JochiSt/OpenHVNanoAmpMeter/README.md

# OpenHVNanoAmpMeter
 Measure Nano Ampere at a high voltage supply
