JochiSt/OpenHVNanoAmpMeter/software/calculations_DDC112/IFS_vs_Tint_vs_CF.png

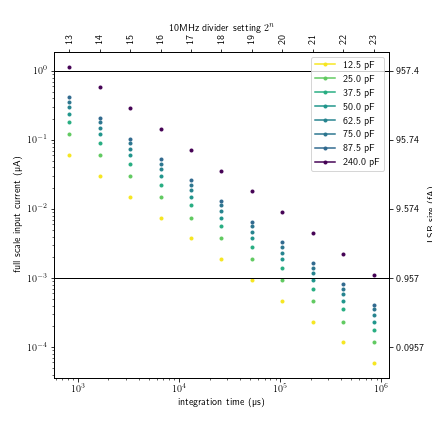
software/calculations_DDC112/IFS_vs_Tint_vs_CF.png
