JochiSt/OpenHVNanoAmpMeter/simulations/CurrentSensor.asc

C1: cap; 10p
C2: cap; 100n
C3: cap; 100n
C4: cap; 10n
C5: cap; 100n
C6: cap; 100n
C7: cap; 100n
C8: cap; 100n
C9: cap; 10n
C10: cap; 100n
C11: cap; 100n
C12: cap; 100n
C13: cap; 10n
C14: cap; 100n
C15: cap; 100n
C16: cap; 100n
I1: current; PWL(0 0 10 1n 20 10n 30 100n)
R1: res; 47Meg
R2: res; 10k
R3: res; 330k
R4: res; 4k7
R5: res; 10k
R6: res; 8k2
R7: res; 82k
R8: res; 47k
R9: res; 100k
R10: res; 10
R11: res; 180k
R12: res; 10k
R13: res; 82k
R14: res; 47k
R15: res; 100k
R16: res; 36k
R17: res; 10k
R18: res; 82k
R19: res; 47k
R20: res; 100k
U1: opamp2; TLC272
U2: LT1493
U3: LT1493
U4: LT1493
V1: voltage; 5; Rser=10
V2: voltage; 5; Rser=10
V3: voltage; 1k
Named nets: V+, V-, Vo, V0, 0, Vi, Vo2_1, Vo2_2, Vo2_3
.lib TLC272.5_1
;tran 100m
Guard Ring
external bias
supply voltage generation
TIA
inv. amplifier
;noise V(Vo2) I1 dec 1000 0.1 1G
low pass filter
low pass filter
.tran 40
low pass filter
use R4 + R5 + R6 + R2 and R3 to 
calculate the amplification
input protection resistor
inv. amplifier
low pass filter
low pass filter
inv. amplifier
low pass filter
low pass filter
