JochiSt/OpenHVNanoAmpMeter/simulations/DDC112/ManchesterCoding/ManchesterCoding.asc

A1: dflop
A2: xor
V1: voltage; PWL file=uart_tx.txt
V2: voltage; PULSE(0 3.3 0 1n 1n 5u 10u)
Named nets: 0, UART_TX, 1b2b
.tran 2m
