JochiSt/OpenHVNanoAmpMeter/OpenHVNanoAmpMeter.kicad_pcb

## KiCad design OpenHVNanoAmpMeter.kicad_pcb (2022-11-25)

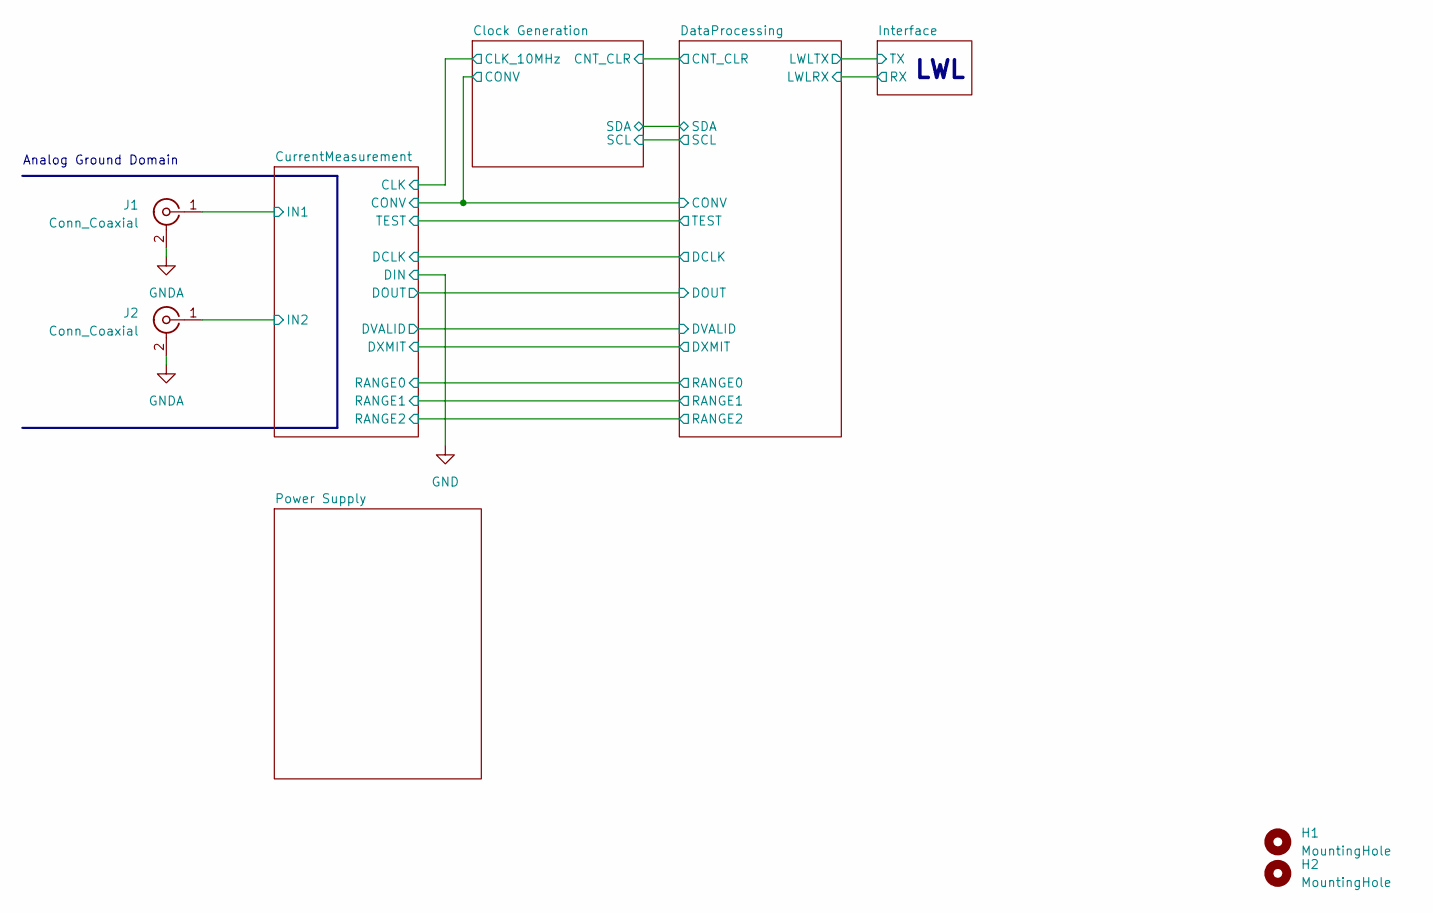
[picture p2: schematic OpenHVNanoAmpMeter.kicad_sch, Open Nano Amp Meter]

Parts:
H1, H2: MountingHole; MountingHole_3.2mm_M3_DIN965
J1, J2: Conn_Coaxial; SMA_Amphenol_132289_EdgeMount

Connections:
/CurrentMeasurement/IN1: J1.1 (In); also elsewhere on the board
/CurrentMeasurement/IN2: J2.1 (In); also elsewhere on the board
GNDA: J1.2 (Ext), J2.2 (Ext); also elsewhere on the board

Notes on the sheet:
LWL
Analog Ground Domain

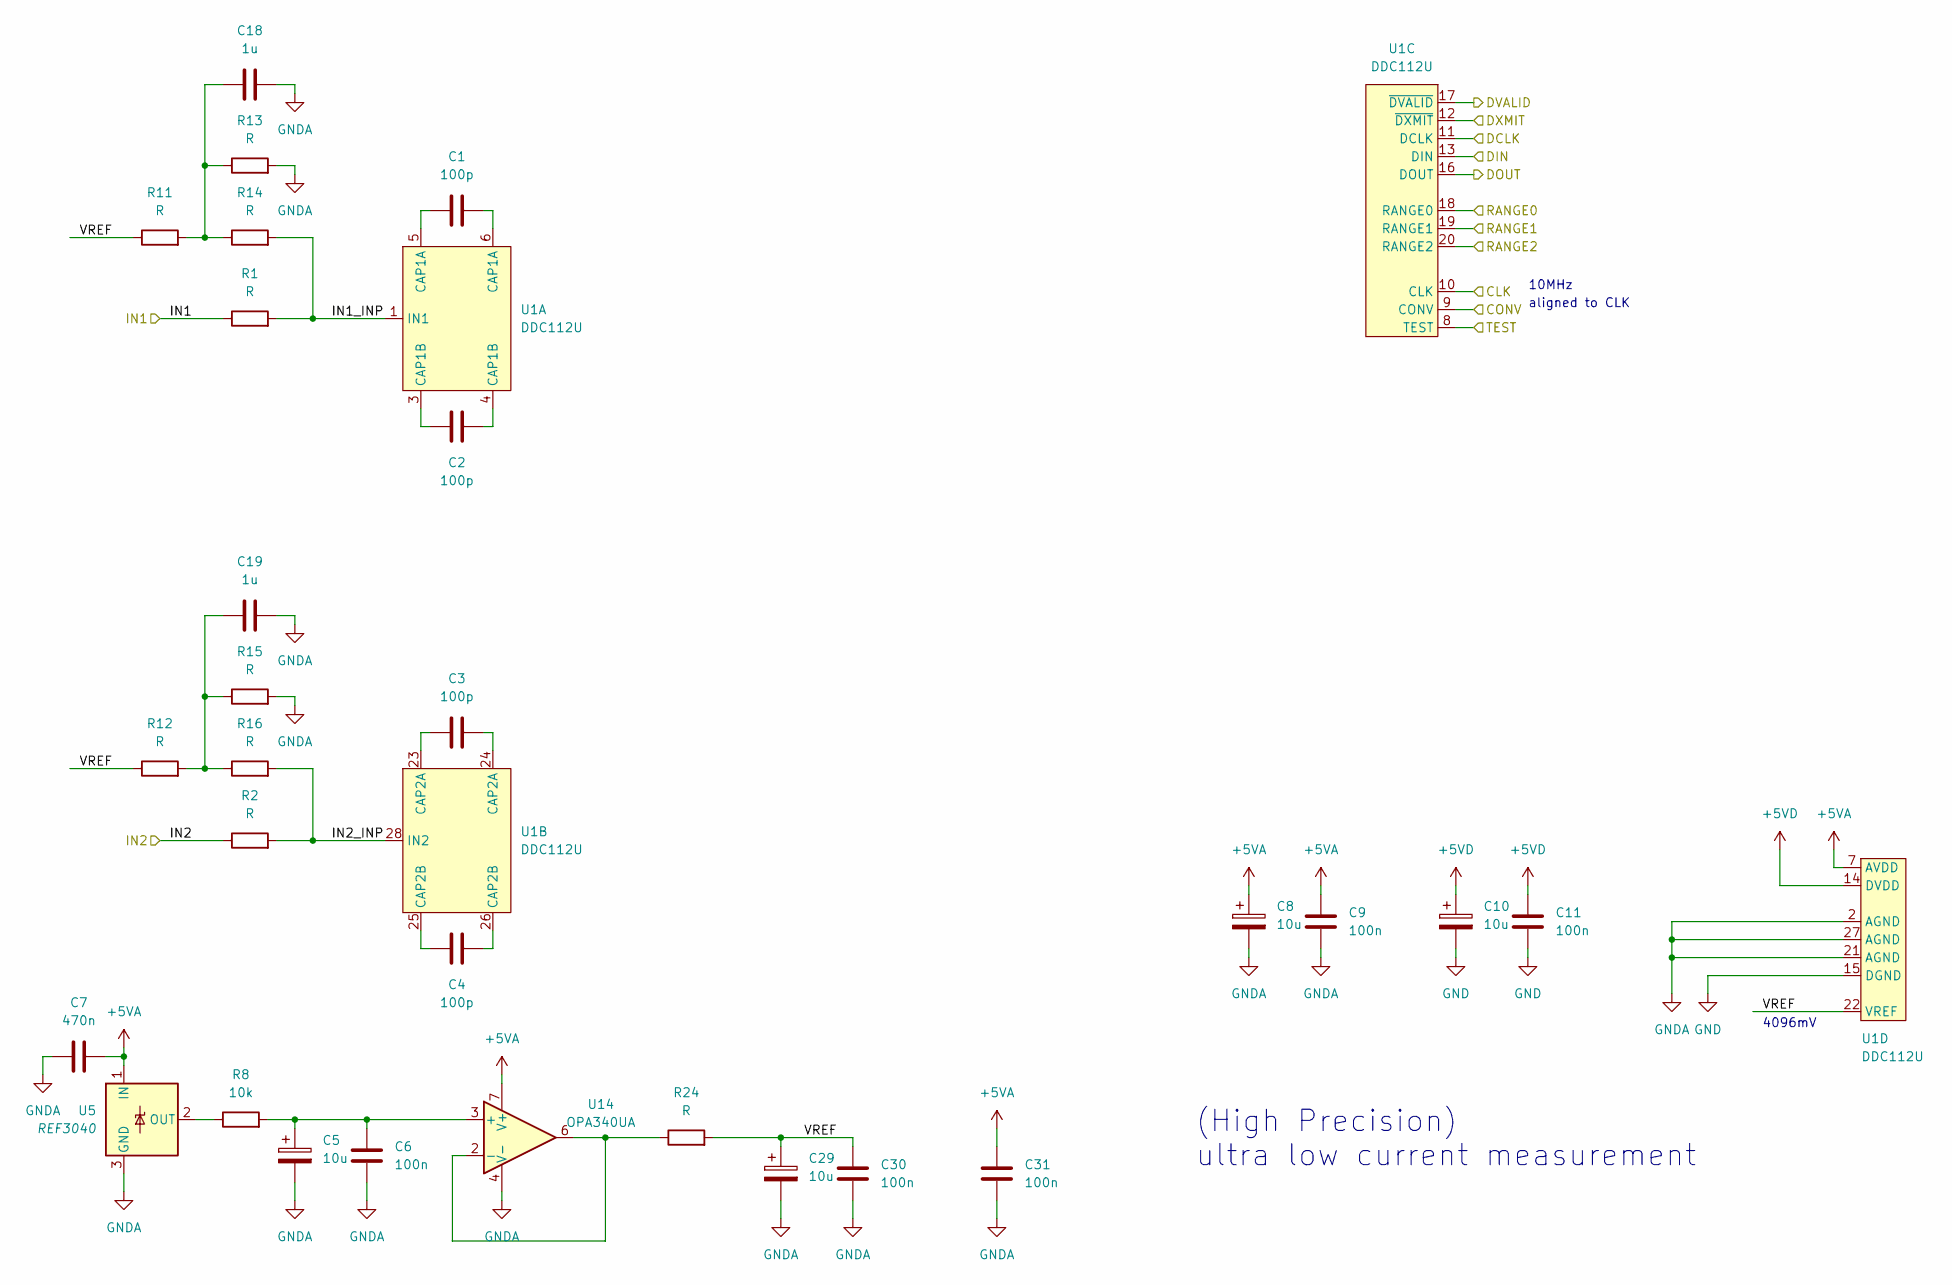
[picture p3: schematic CurrentMeasurement.kicad_sch, Open Nano Amp Meter]

Parts:
C1, C2, C3, C4: 100p; C_0402_1005Metric_Pad0.74x0.62mm_HandSolder
C5, C8, C10, C29: 10u; CP_Elec_4x3.9
C6, C9, C11, C30, C31: 100n; C_0603_1608Metric
C7: 470n; C_0603_1608Metric
C18, C19: 1u; C_0603_1608Metric
R1, R2, R11, R12, R13, R14, R15, R16, R24: R; R_0603_1608Metric
R8: 10k; R_0603_1608Metric
U1: DDC112U; SOIC-28W_7.5x17.9mm_P1.27mm
U5: REF3040; SOT-23
U14: OPA340UA; SOIC-8_3.9x4.9mm_P1.27mm

Connections:
+5VA: C7.2, C8.1, C9.1, C31.1, U1.7 (AVDD), U5.1 (IN), U14.7 (V+); also elsewhere on the board
+5VD: C10.1, C11.1, U1.14 (DVDD); also elsewhere on the board
/Clock Generation/CLK_10MHz: U1.10 (CLK); also elsewhere on the board
/Clock Generation/CONV: U1.9 (CONV); also elsewhere on the board
/CurrentMeasurement/DCLK: U1.11 (DCLK); also elsewhere on the board
/CurrentMeasurement/DOUT: U1.16 (DOUT); also elsewhere on the board
/CurrentMeasurement/DVALID: U1.17 (~DVALID); also elsewhere on the board
/CurrentMeasurement/DXMIT: U1.12 (~DXMIT); also elsewhere on the board
/CurrentMeasurement/IN1: R1.1; also elsewhere on the board
/CurrentMeasurement/IN1_INP: R1.2, R14.2, U1.1 (IN1)
/CurrentMeasurement/IN2: R2.1; also elsewhere on the board
/CurrentMeasurement/IN2_INP: R2.2, R16.2, U1.28 (IN2)
/CurrentMeasurement/RANGE0: U1.18 (RANGE0); also elsewhere on the board
/CurrentMeasurement/RANGE1: U1.19 (RANGE1); also elsewhere on the board
/CurrentMeasurement/RANGE2: U1.20 (RANGE2); also elsewhere on the board
/CurrentMeasurement/TEST: U1.8 (TEST); also elsewhere on the board
/CurrentMeasurement/VREF: C29.1, C30.1, R11.1, R12.1, R24.2, U1.22 (VREF)
GND: C10.2, C11.2, U1.13 (DIN), U1.15 (DGND); also elsewhere on the board
GNDA: C5.2, C6.2, C7.1, C8.2, C9.2, C18.2, C19.2, C29.2, C30.2, C31.2, R13.2, R15.2, U1.2 (AGND), U1.21 (AGND), U1.27 (AGND), U5.3 (GND), U14.4 (V-); also elsewhere on the board
unnamed: C1.1, U1.5 (CAP1A)
unnamed: C1.2, U1.6 (CAP1A)
unnamed: C2.1, U1.3 (CAP1B)
unnamed: C2.2, U1.4 (CAP1B)
unnamed: C3.1, U1.23 (CAP2A)
unnamed: C3.2, U1.24 (CAP2A)
unnamed: C4.1, U1.25 (CAP2B)
unnamed: C4.2, U1.26 (CAP2B)
unnamed: C5.1, C6.1, R8.2, U14.3 (+)
unnamed: C18.1, R11.2, R13.1, R14.1
unnamed: C19.1, R12.2, R15.1, R16.1
unnamed: R8.1, U5.2 (OUT)
unnamed: R24.1, U14.2 (-), U14.6

Notes on the sheet:
4096mV
aligned to CLK
(High Precision) ultra low current measurement
10MHz

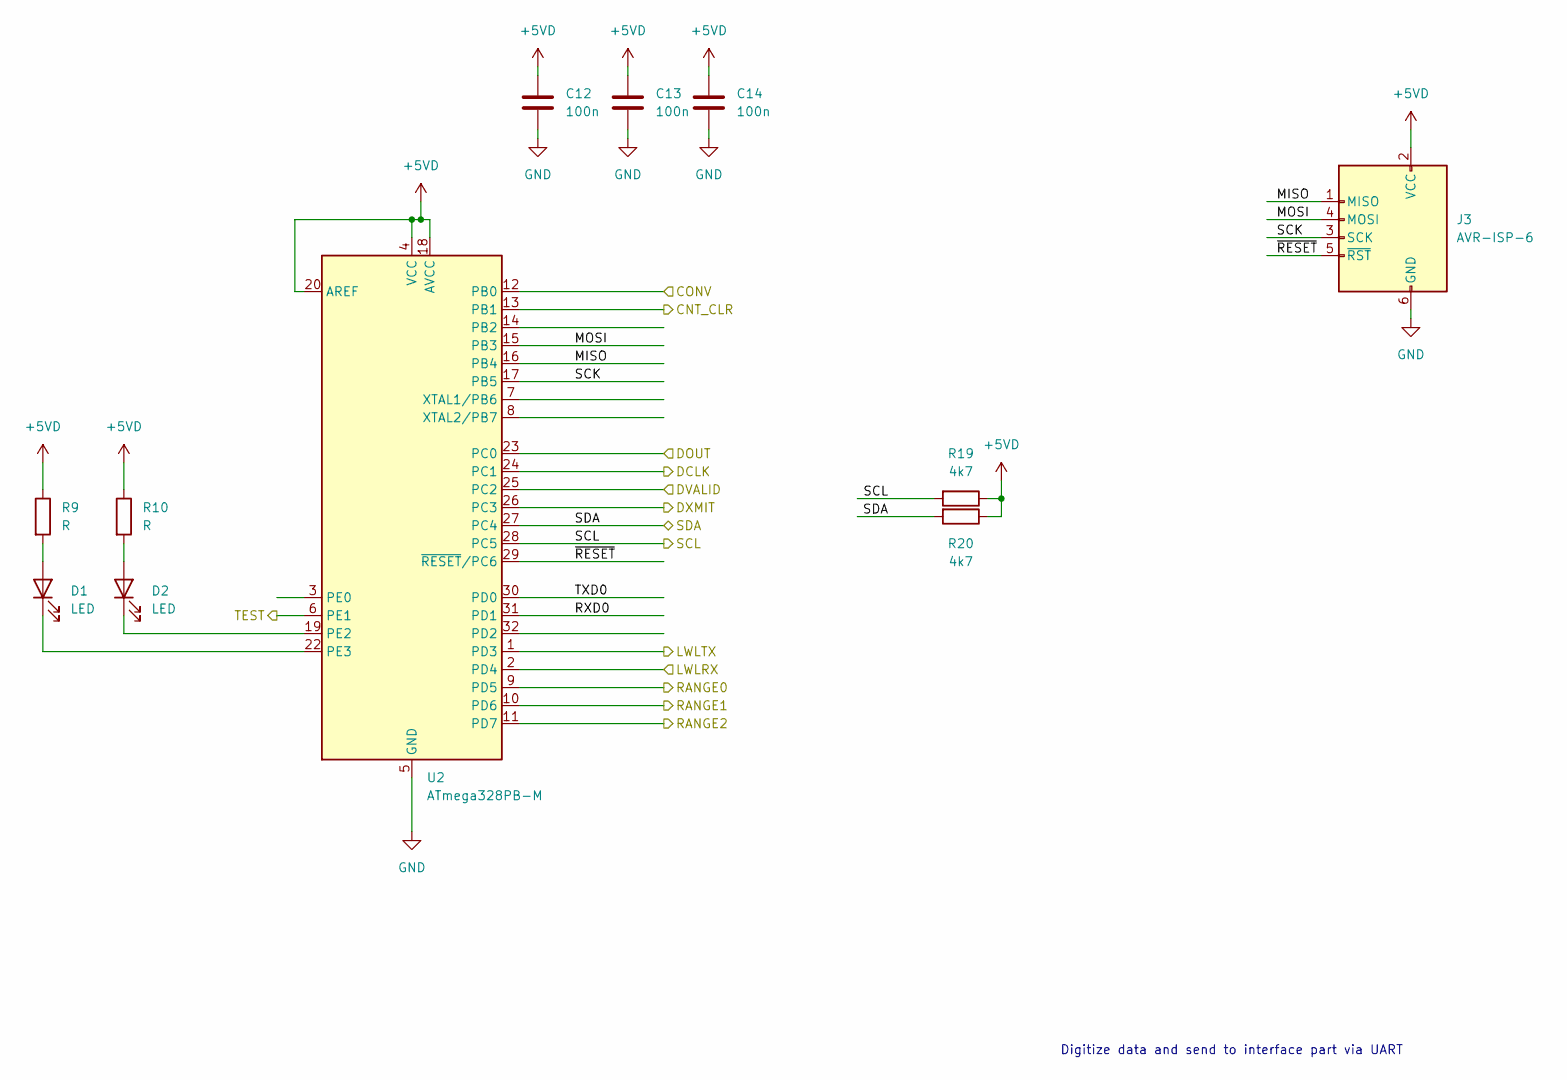
[picture p4: schematic DataProcessing.kicad_sch, Open Nano Amp Meter]

Parts:
C12, C13, C14: 100n; C_0603_1608Metric
D1, D2: LED; LED_0603_1608Metric
J3: AVR-ISP-6; PinHeader_2x03_P2.54mm_Vertical_SMD
R9, R10: R; R_0603_1608Metric
R19, R20: 4k7; R_0603_1608Metric
U2: ATmega328PB-M; QFN-32-1EP_5x5mm_P0.5mm_EP3.1x3.1mm

Connections:
+5VD: C12.1, C13.1, C14.1, J3.2 (VCC), R9.1, R10.1, R19.1, R20.1, U2.4 (VCC), U2.18 (AVCC), U2.20 (AREF); also elsewhere on the board
/Clock Generation/CNT_CLR: U2.13 (PB1); also elsewhere on the board
/Clock Generation/CONV: U2.12 (PB0); also elsewhere on the board
/CurrentMeasurement/DCLK: U2.24 (PC1); also elsewhere on the board
/CurrentMeasurement/DOUT: U2.23 (PC0); also elsewhere on the board
/CurrentMeasurement/DVALID: U2.25 (PC2); also elsewhere on the board
/CurrentMeasurement/DXMIT: U2.26 (PC3); also elsewhere on the board
/CurrentMeasurement/RANGE0: U2.9 (PD5); also elsewhere on the board
/CurrentMeasurement/RANGE1: U2.10 (PD6); also elsewhere on the board
/CurrentMeasurement/RANGE2: U2.11 (PD7); also elsewhere on the board
/CurrentMeasurement/TEST: U2.6 (PE1); also elsewhere on the board
/DataProcessing/LWLRX: U2.2 (PD4); also elsewhere on the board
/DataProcessing/LWLTX: U2.1 (PD3); also elsewhere on the board
/DataProcessing/MISO: J3.1 (MISO), U2.16 (PB4)
/DataProcessing/MOSI: J3.4 (MOSI), U2.15 (PB3)
/DataProcessing/RXD0: U2.31 (PD1)
/DataProcessing/SCK: J3.3 (SCK), U2.17 (PB5)
/DataProcessing/SCL: R19.2, U2.28 (PC5); also elsewhere on the board
/DataProcessing/SDA: R20.2, U2.27 (PC4); also elsewhere on the board
/DataProcessing/TXD0: U2.30 (PD0)
/DataProcessing/~RESET: J3.5 (~RST), U2.29 (~RESET/PC6)
GND: C12.2, C13.2, C14.2, J3.6 (GND), U2.5 (GND), U2.21 (GND), U2.33 (GND); also elsewhere on the board
unnamed: D1.1 (K), U2.22 (PE3)
unnamed: D1.2 (A), R9.2
unnamed: D2.1 (K), U2.19 (PE2)
unnamed: D2.2 (A), R10.2

Notes on the sheet:
Digitize data and send to interface part via UART

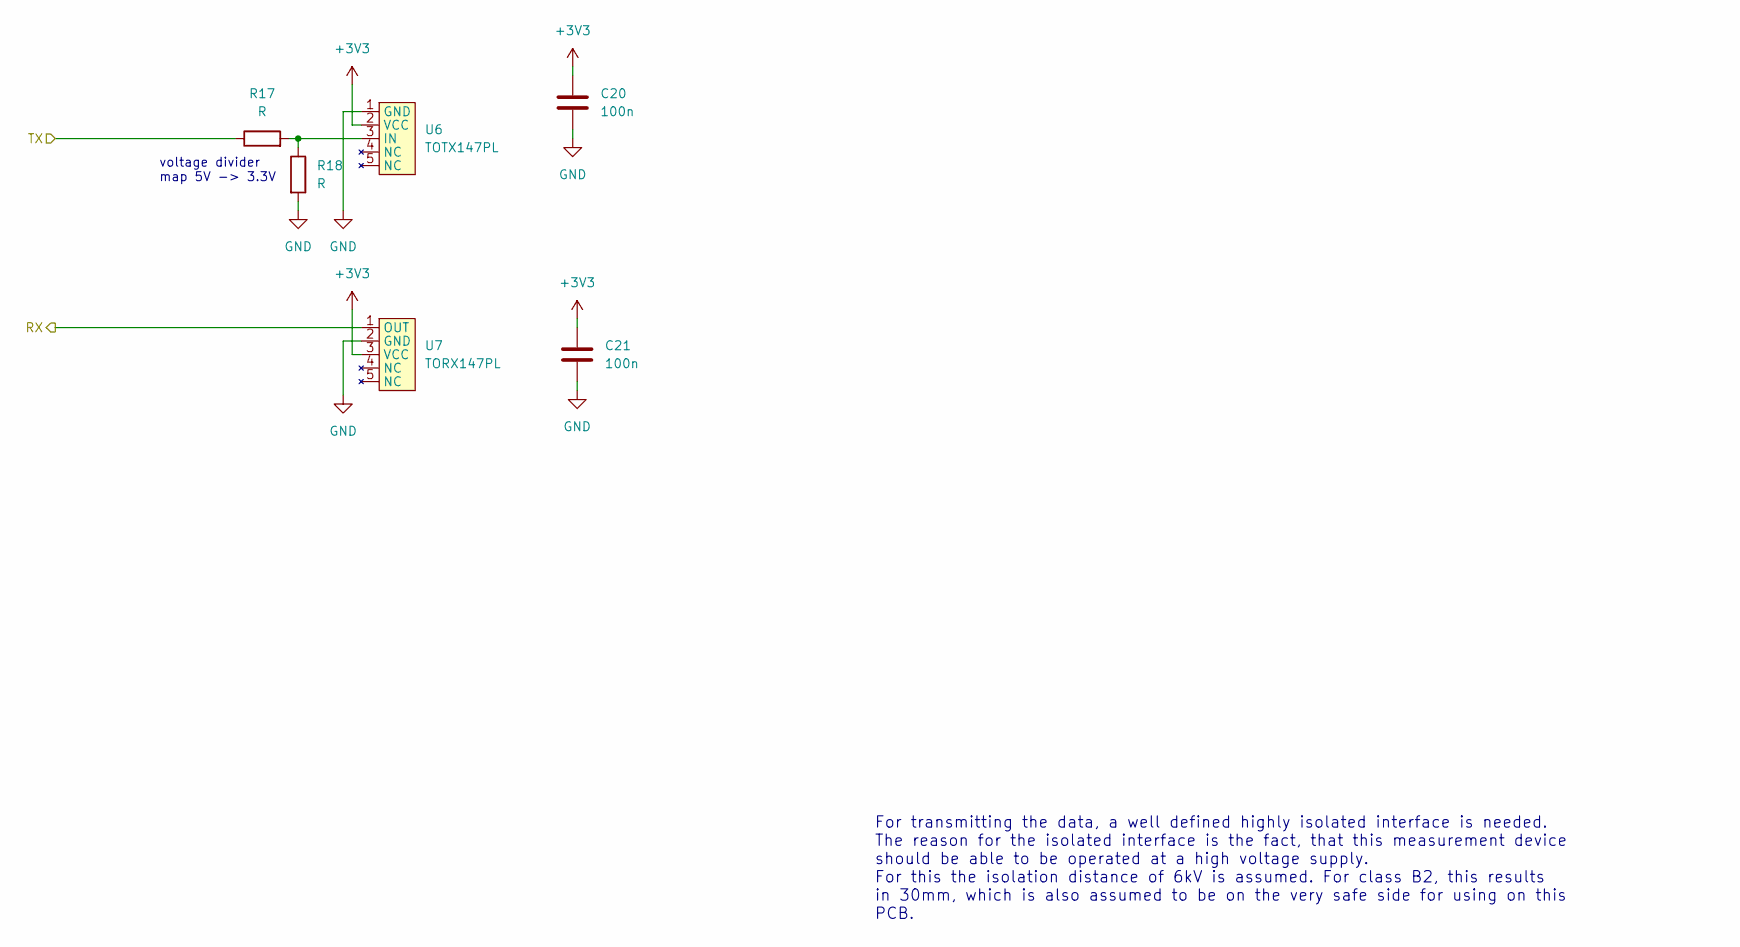
[picture p5: schematic Interface.kicad_sch, Open Nano Amp Meter]

Parts:
C20, C21: 100n; C_0603_1608Metric
R17, R18: R; R_0603_1608Metric
U6: TOTX147PL
U7: TORX147PL

Connections:
+3V3: C20.1, C21.1, U6.2 (VCC), U7.3 (VCC); also elsewhere on the board
/DataProcessing/LWLRX: U7.1 (OUT); also elsewhere on the board
/DataProcessing/LWLTX: R17.1; also elsewhere on the board
GND: C20.2, C21.2, R18.2, U6.1 (GND), U7.2 (GND); also elsewhere on the board
unnamed: R17.2, R18.1, U6.3 (IN)

Notes on the sheet:
voltage divider map 5V -> 3.3V
For transmitting the data, a well defined highly isolated interface is needed. The reason for the isolated interface is the fact, that this measurement device should be able to be operated at a high voltage supply. For this the isolation distance of 6kV is assumed. For class B2, this results in 30m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

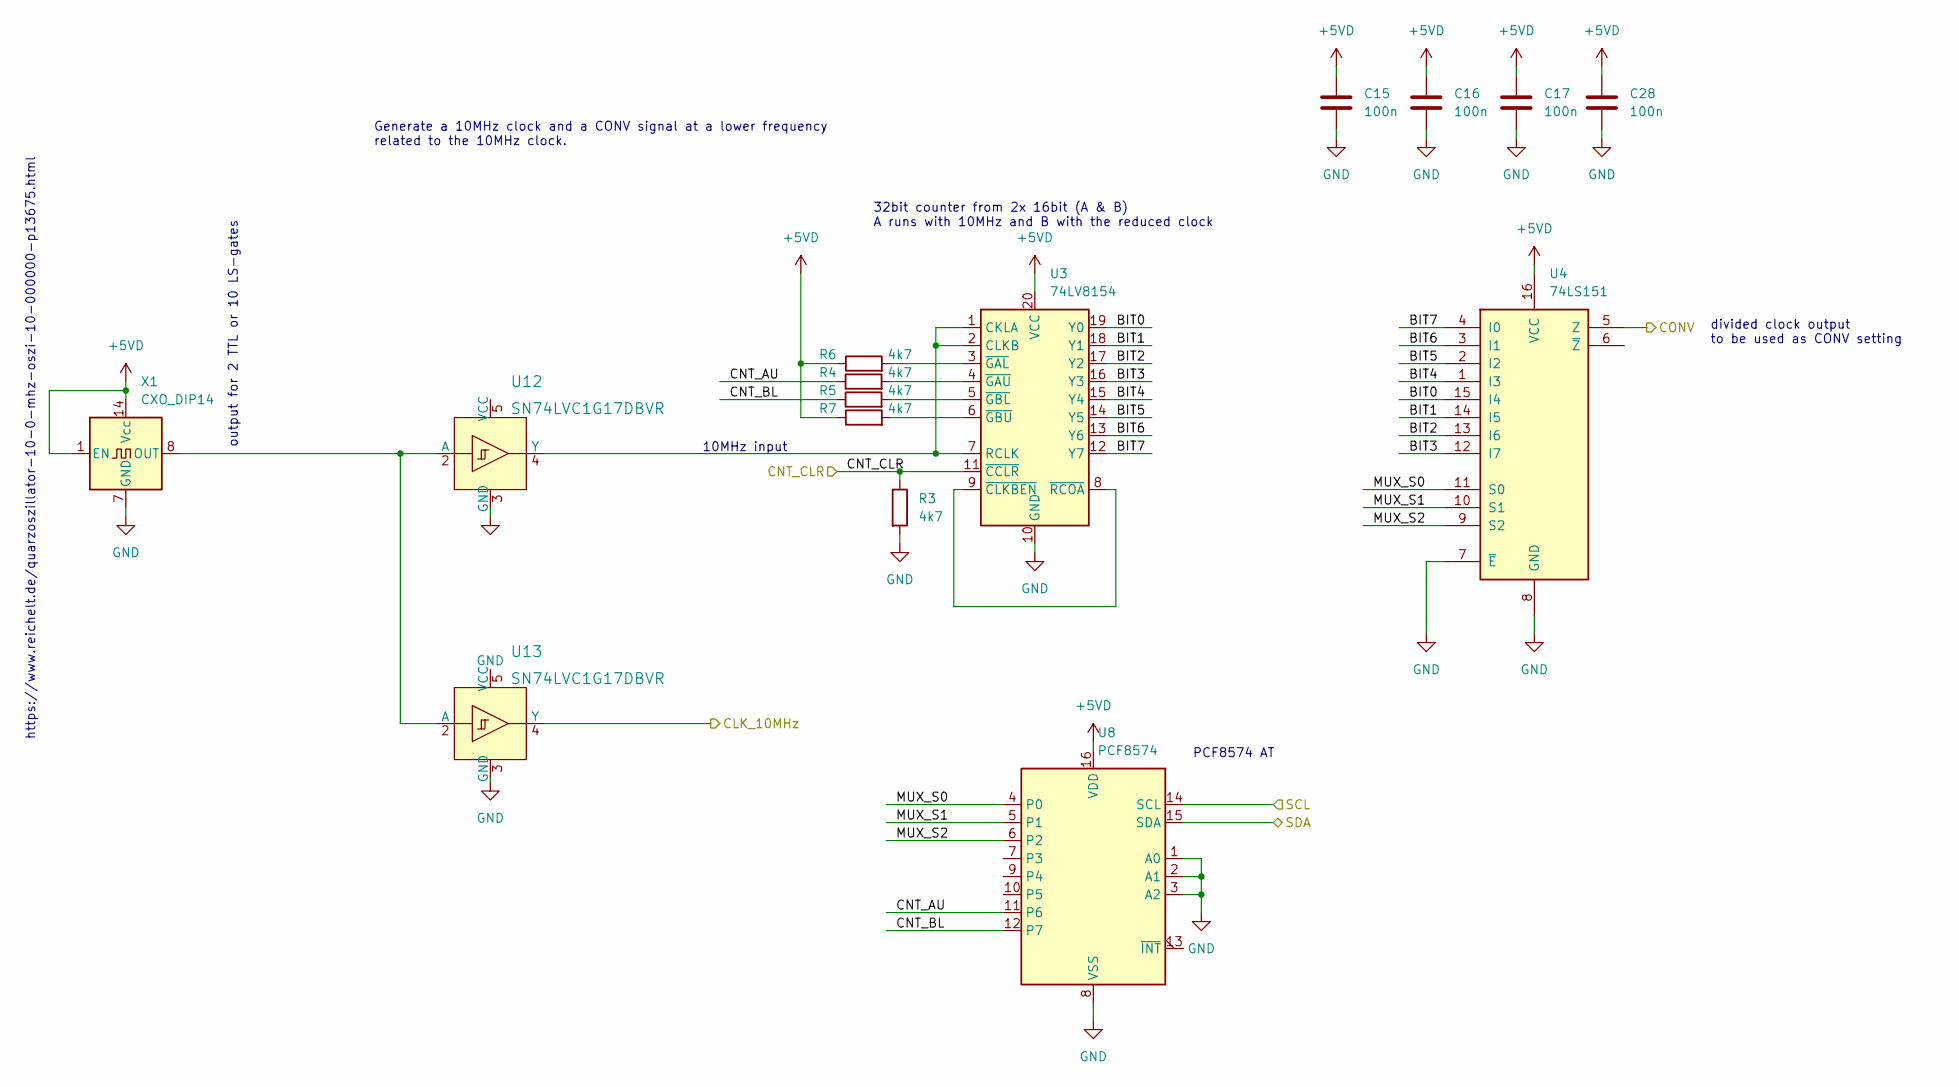
[picture p6: schematic Clock_10MHz.kicad_sch, Open Nano Amp Meter]

Parts:
C15, C16, C17, C28: 100n; C_0603_1608Metric
R3: 4k7; R_0603_1608Metric
R4, R5, R6, R7: 4k7; R_0402_1005Metric
U3: 74LV8154; TSSOP-20_4.4x6.5mm_P0.65mm
U4: 74LS151; SO-16_3.9x9.9mm_P1.27mm
U8: PCF8574; SOIC-16W_7.5x10.3mm_P1.27mm
U12, U13: SN74LVC1G17DBVR; SOT-753; MPN SN74LVC1G17DBVR; Digi-Key_PN 296-11933-1-ND
X1: CXO_DIP14; Oscillator_DIP-14

Connections:
+5VD: C15.1, C16.1, C17.1, C28.1, R6.1, R7.1, U3.20 (VCC), U4.16 (VCC), U8.16 (VDD), X1.1 (EN), X1.14 (Vcc); also elsewhere on the board
/Clock Generation/BIT0: U3.19 (Y0), U4.15 (I4)
/Clock Generation/BIT1: U3.18 (Y1), U4.14 (I5)
/Clock Generation/BIT2: U3.17 (Y2), U4.13 (I6)
/Clock Generation/BIT3: U3.16 (Y3), U4.12 (I7)
/Clock Generation/BIT4: U3.15 (Y4), U4.1 (I3)
/Clock Generation/BIT5: U3.14 (Y5), U4.2 (I2)
/Clock Generation/BIT6: U3.13 (Y6), U4.3 (I1)
/Clock Generation/BIT7: U3.12 (Y7), U4.4 (I0)
/Clock Generation/CLK_10MHz: U13.4 (Y); also elsewhere on the board
/Clock Generation/CNT_AU: R4.1, U8.11 (P6)
/Clock Generation/CNT_BL: R5.1, U8.12 (P7)
/Clock Generation/CNT_CLR: R3.1, U3.11 (~CCLR); also elsewhere on the board
/Clock Generation/CONV: U4.5 (Z); also elsewhere on the board
/Clock Generation/MUX_S0: U4.11 (S0), U8.4 (P0)
/Clock Generation/MUX_S1: U4.10 (S1), U8.5 (P1)
/Clock Generation/MUX_S2: U4.9 (S2), U8.6 (P2)
/DataProcessing/SCL: U8.14 (SCL); also elsewhere on the board
/DataProcessing/SDA: U8.15 (SDA); also elsewhere on the board
GND: C15.2, C16.2, C17.2, C28.2, R3.2, U3.10 (GND), U4.7 (~E), U4.8 (GND), U8.1 (A0), U8.2 (A1), U8.3 (A2), U8.8 (VSS), U12.3 (GND), U13.3 (GND), X1.7 (GND); also elsewhere on the board
unnamed: R4.2, U3.4 (~GAU)
unnamed: R5.2, U3.5 (~GBL)
unnamed: R6.2, U3.3 (~GAL)
unnamed: R7.2, U3.6 (~GBU)
unnamed: U3.8 (~RCOA), U3.9 (~CLKBEN)
unnamed: U12.2 (A), U13.2 (A), X1.8 (OUT)
unnamed: U3.1 (CKLA), U3.2 (CLKB), U3.7 (RCLK), U12.4 (Y)

Notes on the sheet:
https://www.reichelt.de/quarzoszillator-10-0-mhz-oszi-10-000000-p13675.html
32bit counter from 2x 16bit (A & B) A runs with 10MHz and B with the reduced clock
output for 2 TTL or 10 LS-gates
Generate a 10MHz clock and a CONV signal at a lower frequency related to the 10MHz clock.
10MHz input
divided clock output to be used as CONV setting
PCF8574 AT

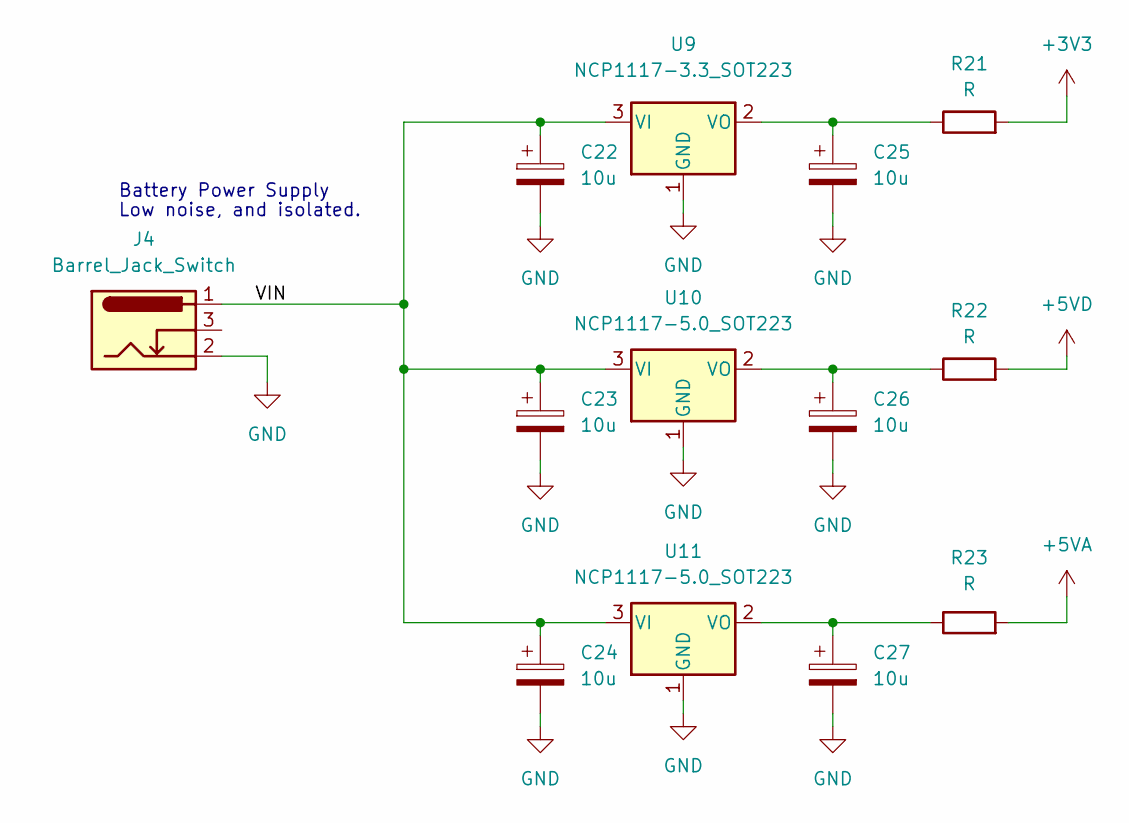
[picture p7: schematic powersupply.kicad_sch, Open Nano Amp Meter]

Parts:
C22, C23, C24, C25, C26, C27: 10u; CP_Elec_4x3.9
J4: Barrel_Jack_Switch; BarrelJack_Wuerth_6941xx301002
R21, R22, R23: R; R_0603_1608Metric
U9: NCP1117-3.3_SOT223; SOT-223-3_TabPin2
U10, U11: NCP1117-5.0_SOT223; SOT-223-3_TabPin2

Connections:
+3V3: R21.2; also elsewhere on the board
+5VA: R23.2; also elsewhere on the board
+5VD: R22.2; also elsewhere on the board
/Power Supply/VIN: C22.1, C23.1, C24.1, J4.1, U9.3 (VI), U10.3 (VI), U11.3 (VI)
GND: C22.2, C23.2, C24.2, C25.2, C26.2, C27.2, J4.2, U9.1 (GND), U10.1 (GND), U11.1 (GND); also elsewhere on the board
unnamed: C25.1, R21.1, U9.2 (VO)
unnamed: C26.1, R22.1, U10.2 (VO)
unnamed: C27.1, R23.1, U11.2 (VO)

Notes on the sheet:
Battery Power Supply
Low noise, and isolated.

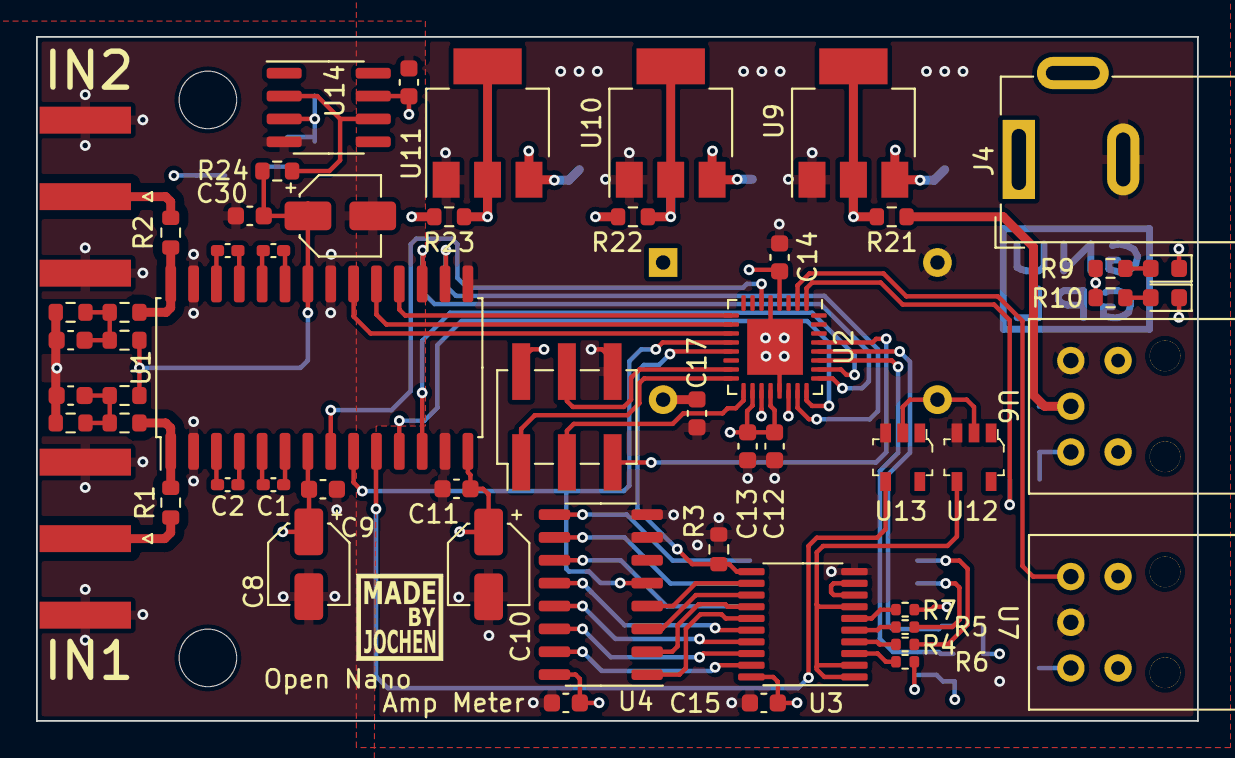
[picture p8: board OpenHVNanoAmpMeter.kicad_pcb from above]

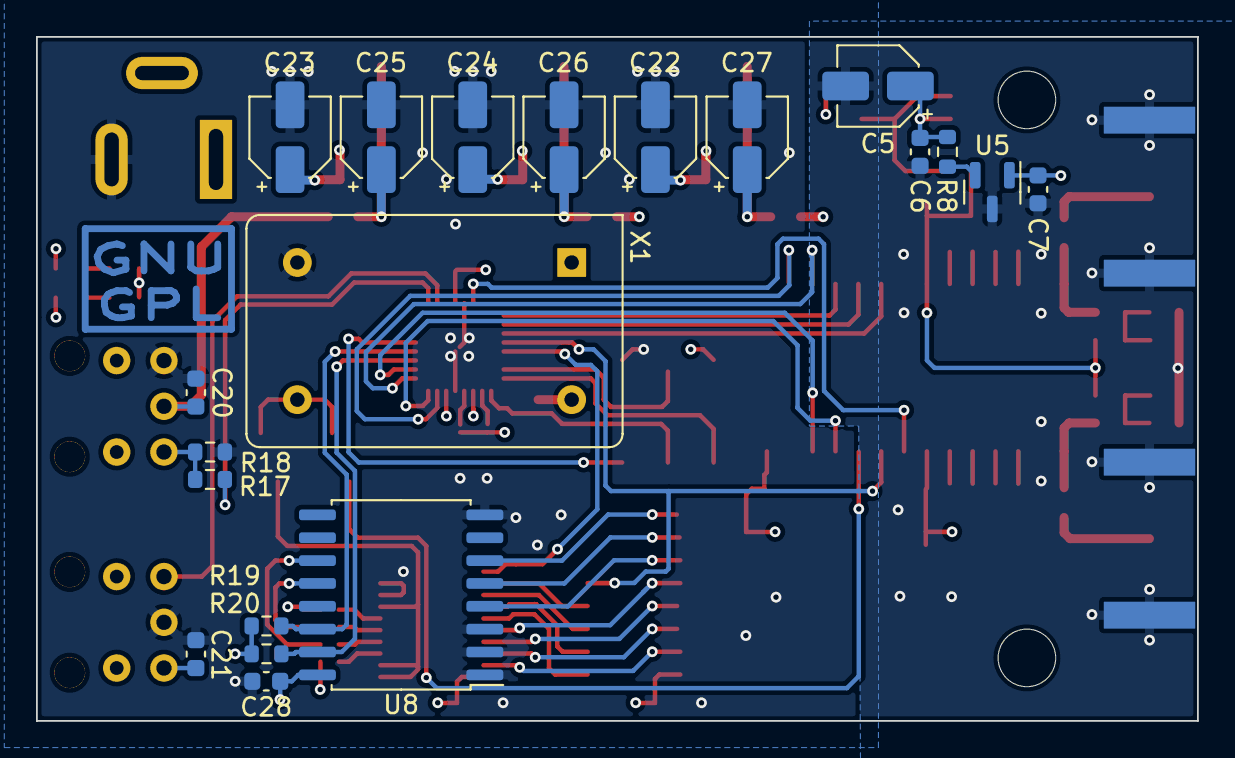
[picture p9: board OpenHVNanoAmpMeter.kicad_pcb from below]

Board: 4 copper layers, 64.5 x 38.0 mm, 78 parts (20 on the bottom side), 71 nets.
