JochiSt/OpenHVNanoAmpMeter/(commit log)

2022-10-26 added rough project structure
    [CurrentMeasurement.kicad_sch, DataProcessing.kicad_sch, Interface.kicad_sch, InterfacePCside.kicad_sch, OpenHVNanoAmpMeter.kicad_pcb, OpenHVNanoAmpMeter.kicad_sch]
2022-10-27 added simulation for current measurement
2022-10-27 added low pass filtering
    this reduces the bandwidth, but for stady state current measurements, this might increase the stability and reduces the noise impact. On the other hand, this needs proper tuning, because the filtering components might also introduce noise.
2022-10-27 added a link to one TLC272 example circuit
2022-10-27 fixed 2nd stage amplification
2022-10-27 added more current output channels
    for getting more ranges
2022-10-27 added TIA schematic
    started with TLC272
    [CurrentMeasurement.kicad_sch]
2022-10-27 updated structure
    [OpenHVNanoAmpMeter.kicad_sch]
2022-11-15 changed from TIA to DDC112, because this might be the simpler approach
    [CurrentMeasurement.kicad_sch]
2022-11-15 added a comment to the interface about constrains
    [Interface.kicad_sch]
2022-11-15 added hierachical ports to sheet
    [OpenHVNanoAmpMeter.kicad_sch]
2022-11-15 started layout with DDC112
    [OpenHVNanoAmpMeter.kicad_pcb]
2022-11-15 added ports for interface section
    [Interface.kicad_sch]
2022-11-16 added script for DDC112 parameter estimation
    script calculates valid clock divider settings and the full scale current
2022-11-16 added 10 MHz and CONV generation
    using a counter and a MUX various integration times are possible
    [Clock_10MHz.kicad_sch]
2022-11-16 started dataprocessing
    using a Atmega328PB
    [DataProcessing.kicad_sch]
2022-11-16 added coax connectors as input
    [OpenHVNanoAmpMeter.kicad_sch]
2022-11-16 included input resistors
    [CurrentMeasurement.kicad_sch]
2022-11-16 started some layouting
    [OpenHVNanoAmpMeter.kicad_pcb]
2022-11-16 use proper capacitance value
2022-11-16 use uA for displaying the fullscale current
2022-11-16 use 2nd X axis to display the clock divider setting
2022-11-16 added 2nd y axis for LSB size
    include the calculation of the LSB size to give a hint towards the sensitivity of the system
2022-11-16 fixed y axis label
    and added comment about calculation of axis ticks
2022-11-16 remove debug print
2022-11-16 connected the ICs to 5V digital power
    [Clock_10MHz.kicad_sch, CurrentMeasurement.kicad_sch, DataProcessing.kicad_sch, Interface.kicad_sch]
2022-11-17 power annotation
    [Clock_10MHz.kicad_sch, CurrentMeasurement.kicad_sch, DataProcessing.kicad_sch, Interface.kicad_sch]
2022-11-17 added decoupling Cs
    [Clock_10MHz.kicad_sch, DataProcessing.kicad_sch]
2022-11-17 added decoupling Cs + reference voltage generation
    for reference voltage generation, the buffer OPamp is missing
    [CurrentMeasurement.kicad_sch]
2022-11-17 small project updates
    [OpenHVNanoAmpMeter.kicad_sch]
2022-11-17 proceeded with routing
    [OpenHVNanoAmpMeter.kicad_pcb]
2022-11-17 ISP connection routed
    [OpenHVNanoAmpMeter.kicad_pcb]
2022-11-17 changed title block to meaningful information
    [Clock_10MHz.kicad_sch, CurrentMeasurement.kicad_sch, DataProcessing.kicad_sch, Interface.kicad_sch, InterfacePCside.kicad_sch, OpenHVNanoAmpMeter.kicad_sch]
2022-11-17 enumeration done
    [Clock_10MHz.kicad_sch]
2022-11-17 added 2 LEDs for some status output
    [DataProcessing.kicad_sch]
2022-11-18 added option to make the input bipolar
    [CurrentMeasurement.kicad_sch]
2022-11-18 changed resistor footprint to 0603
    [DataProcessing.kicad_sch]
2022-11-18 added GitHub Gist for generating a UART PWL file
2022-11-23 added TOSLINK TO?X147PL footprints
2022-11-23 updated title block
    [powersupply.kicad_sch]
2022-11-23 added TOSLINK RX & TX
    [Interface.kicad_sch]
2022-11-23 changed setting of clock divider to I2C
    reduces pin load on uC, thus frees pins for usage with other functions.
    [Clock_10MHz.kicad_sch, DataProcessing.kicad_sch, OpenHVNanoAmpMeter.kicad_sch]
2022-11-23 added labels to input sections
    [CurrentMeasurement.kicad_sch]
2022-11-24 added 3 linear regulators
    [powersupply.kicad_sch]
2022-11-24 added mounting holes and renamed TX & RX to LWL*
    [OpenHVNanoAmpMeter.kicad_sch]
2022-11-24 added 100nF decoupling and global 3V3 net
    [Interface.kicad_sch]
2022-11-24 implemented I2C incl. pullups
    [DataProcessing.kicad_sch]
2022-11-24 implemented linear regulators
    [Clock_10MHz.kicad_sch, OpenHVNanoAmpMeter.kicad_pcb]
2022-11-24 added 0.5mm width constrain
2022-11-24 updated 10MHz oscillator to DIP 14 package
    needs larger PCB space, but much easier to purchase
    [Clock_10MHz.kicad_sch, OpenHVNanoAmpMeter.kicad_pcb, OpenHVNanoAmpMeter.kicad_sch]
2022-11-24 inlcuded buffer for 10MHz clock
    otherwise the oscillator does not have enough drive strength
    [Clock_10MHz.kicad_sch, OpenHVNanoAmpMeter.kicad_pcb, OpenHVNanoAmpMeter.kicad_sch]
2022-11-24 added buffer to ref voltage generation
    [CurrentMeasurement.kicad_sch, OpenHVNanoAmpMeter.kicad_pcb, OpenHVNanoAmpMeter.kicad_sch]
2022-11-24 added note to PCF8574
    [Clock_10MHz.kicad_sch]
2022-11-24 added MadeByJochen + GPL symbol
    [OpenHVNanoAmpMeter.kicad_pcb]
2022-11-24 small tidy up of traces
    [OpenHVNanoAmpMeter.kicad_pcb]
2022-11-24 layout partially done
    almost final routing (needs many checks and tests)
    [OpenHVNanoAmpMeter.kicad_pcb]
2022-11-25 DRC clean layout (incl. exclusion of violations)
    [OpenHVNanoAmpMeter.kicad_pcb]
2022-12-31 added plot integration time vs. full scale current
